drhigsby/letitslide/_QMK stuff/letitslide/readme.md

# Let It Slide!

Let It Slide!

Let It Slide! Is a 14u wide 40% keyboard featuring a potentiometer slider and full punctuation.   

* Keyboard Maintainer: [H. Bond](https://github.com/drhigsby)
* Hardware Supported: Let It Slide! (https://github.com/drhigsby/letitslide)
* Hardware Availability: Make your own

Make example for this keyboard (after setting up your build environment):

    make letitslide:default

See the [build environment setup](https://docs.qmk.fm/#/getting_started_build_tools) and the [make instructions](https://docs.qmk.fm/#/getting_started_make_guide) for more information. Brand new to QMK? Start with our [Complete Newbs Guide](https://docs.qmk.fm/#/newbs).
