drhigsby/letitslide/_Case/DXFs/letItSlide LAYER E x1.dxf

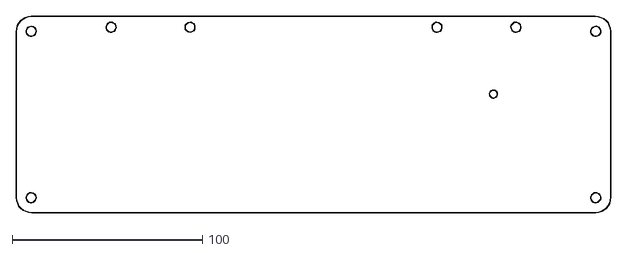
[picture p1: CAD file, 2022-01-31]
_Case/DXFs/letItSlide LAYER E x1.dxf
312.8 x 103.2
