drhigsby/letitslide/_Case/DXFs/letItSlide LAYER C1 x1.dxf

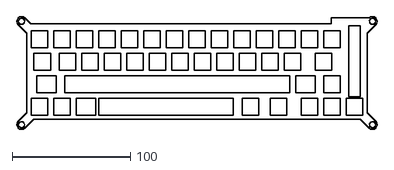
[picture p2: CAD file, 2022-01-31]
_Case/DXFs/letItSlide LAYER C1 x1.dxf
305.8 x 96.3
