drhigsby/letitslide/_Case/DXFs/letItSlide LAYER B x1.dxf

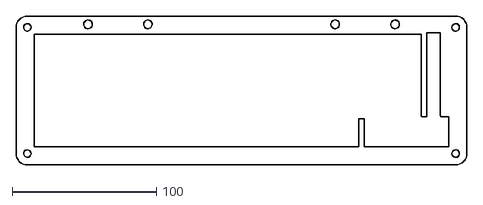
[picture p3: CAD file, 2022-01-31]
_Case/DXFs/letItSlide LAYER B x1.dxf
312.8 x 103.2
