drhigsby/letitslide/_Case/DXFs/letItSlide Foot A x2.dxf

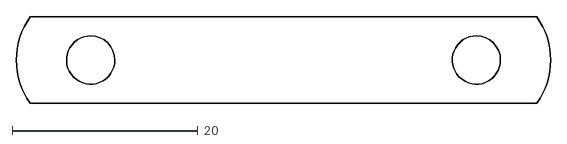
[picture p5: CAD file, 2022-01-31]
_Case/DXFs/letItSlide Foot A x2.dxf
57.5 x 9.29
