drhigsby/letitslide/_Case/DXFs/letItSlide LAYER A x1.dxf

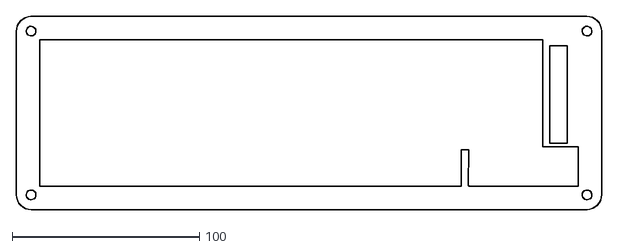
[picture p6: CAD file, 2022-01-31]
_Case/DXFs/letItSlide LAYER A x1.dxf
312.8 x 103.2
