drhigsby/letitslide/_Case/DXFs/letItSlide Foot B x4.dxf

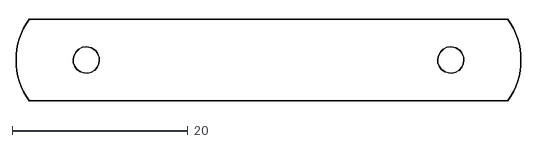
[picture p7: CAD file, 2022-01-31]
_Case/DXFs/letItSlide Foot B x4.dxf
57.5 x 9.29
