drhigsby/letitslide/_Case/DXFs/letItSlide LAYER D x3.dxf

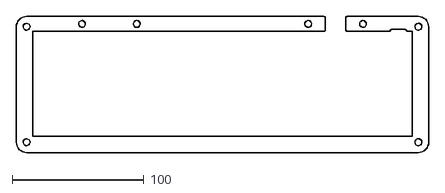
[picture p8: CAD file, 2022-01-31]
_Case/DXFs/letItSlide LAYER D x3.dxf
312.8 x 103.2
