drhigsby/letitslide/letItSlide.kicad_pcb

## KiCad design letItSlide.kicad_pcb (2022-04-28)

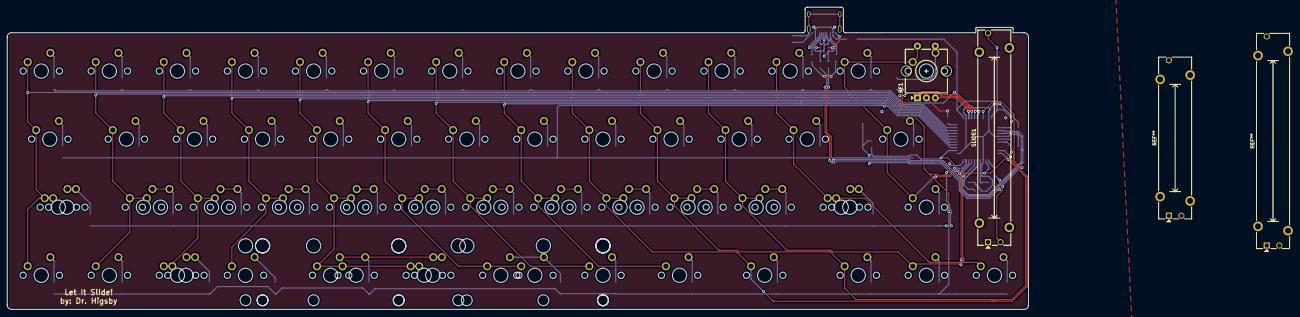
[picture p9: board letItSlide.kicad_pcb from above]

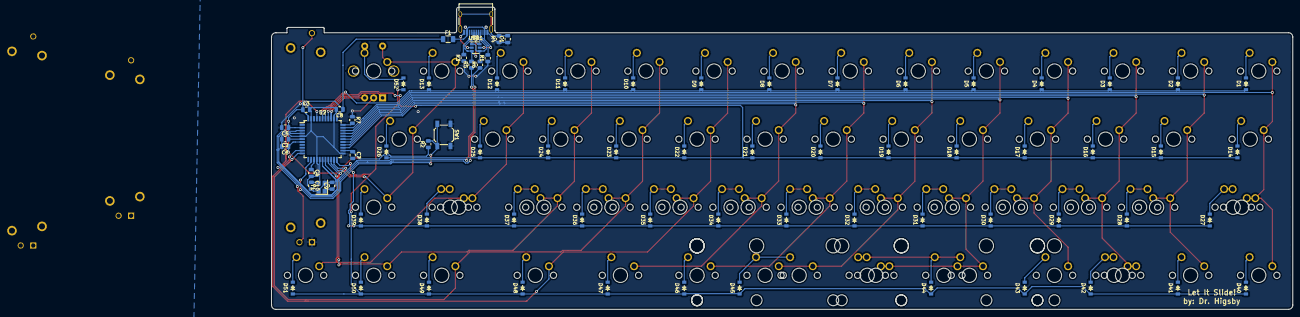
[picture p10: board letItSlide.kicad_pcb from below]

Board: 2 copper layers, 285.8 x 84.5 mm, 146 parts (75 on the bottom side), 87 nets.

Parts:
C1: 4.7n; C_0805_2012Metric
C2: 1uF; C_0805_2012Metric
C3, C4, C5, C6, C7: 0.1uF; C_0805_2012Metric
C8: 10uF; C_0805_2012Metric
C9, C10: 22; C_0805_2012Metric
D1, D2, D3, D4, D5, D6, D7, D8, D9, D10, D11, D12, D13, D14, D15, D16, D17, D18, D19, D20, D21, D22, D23, D24, D25, D26, D27, D28, D29, D30, D31, D32, D33, D34, D35, D36, D37, D38, D39, D40, D41, D42, D43, D44, D45, D46, D47, D48, D49, D50, D51, D52: D_Small; D_SOD-123
F1: 500 mA; Fuse_1206_3216Metric
MX1, MX2, MX3, MX4, MX5, MX6, MX7, MX8, MX9, MX10, MX11, MX12, MX13, MX15, MX16, MX17, MX18, MX19, MX20, MX21, MX22, MX23, MX24, MX25, MX28, MX28#2, MX29, MX29#2, MX30, MX30#2, MX31, MX31#2, MX32, MX32#2, MX33, MX33#2, MX34, MX34#2, MX35, MX35#2, MX36, MX36#2, MX37, MX37#2, MX39, MX40, MX41, MX42, MX43, MX46, MX49, MX50, MX51, MX52: MX-NoLED; MXOnly-1U-NoLED
MX14, MX38-1.25u1, MX42-1.25u1, MX47, MX48: MX-NoLED; MXOnly-1.25U-NoLED
MX26, MX27-1.75u1: MX-NoLED; MXOnly-1.75U-NoLED
MX27, MX38: MX-NoLED; MXOnly-1.5U-NoLED
MX44: MX-NoLED; MXOnly-2.25U-ReversedStabilizers-NoLED
MX44-3u1, MX45-3u1: MX-NoLED; MXOnly-3U-ReversedStabilizers-NoLED
MX44-6.25u1: MX-NoLED; MXOnly-6.25U-ReversedStabilizers-NoLED
MX44-6u1: MX-NoLED; MXOnly-6U-Centered-ReversedStabilizers-NoLED
MX45: MX-NoLED; MXOnly-2U-ReversedStabilizers-NoLED
R1, R3: 5.1k; R_0805_2012Metric
R2, R7: 10k; R_0805_2012Metric
R4: 1M; R_0805_2012Metric
R5, R6: 22; R_0805_2012Metric
RE1: Rotary_Encoder_Switch; RotaryEncoder_Alps_EC11E-Switch_Vertical_H20mm_CircularMoun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
SLIDE1: Conn_01x07_Male; Potentiometer_Bourns_PTA4543_Single_Slide
SW1: SW_Push; SW_SPST_SKQG_WithStem
U1: SRV05-4; SOT-23-6
U2: ATmega32U4-AU; TQFP-44_10x10mm_P0.8mm
USB1: USB_C_Receptacle_USB2.0; USB_C_Receptacle_HRO_TYPE-C-31-M-12
Y1: Crystal_GND24_Small; Crystal_SMD_3225-4Pin_3.2x2.5mm

Connections:
+5V: C3.1, C4.1, C5.1, C6.1, C7.1, C8.1, F1.1, R2.1, SLIDE1.3, U2.2, U2.7, U2.14, U2.24, U2.34, U2.44
ANAL_IN: SLIDE1.2, U2.41
D+: R5.2, U1.3, U1.6, USB1.A6, USB1.B6
D-: R6.2, U1.1, U1.4, USB1.A7, USB1.B7
Earth: C1.2, R4.2, USB1.S1
GND: C1.1, C2.2, C3.2, C4.2, C5.2, C6.2, C7.2, C8.2, C9.2, C10.2, R1.1, R3.1, R4.1, R7.1, RE1.C, SLIDE1.1, SW1.1, U1.2, U2.5, U2.15, U2.23, U2.35, U2.43, USB1.A1, USB1.A12, USB1.B1, USB1.B12, Y1.2, Y1.4
MG1: RE1.B, U2.36
MG2: RE1.A, U2.37
unnamed: C2.1, U2.6
unnamed: C9.1, U2.17, Y1.1
unnamed: C10.1, U2.16, Y1.3
unnamed: D1.2, MX1.2
unnamed: D2.2, MX2.2
unnamed: D3.2, MX3.2
unnamed: D4.2, MX4.2
unnamed: D5.2, MX5.2
unnamed: D6.2, MX6.2
unnamed: D7.2, MX7.2
unnamed: D8.2, MX8.2
unnamed: D9.2, MX9.2
unnamed: D10.2, MX10.2
unnamed: D11.2, MX11.2
unnamed: D12.2, MX12.2
unnamed: D13.2, MX13.2
unnamed: D14.2, MX14.2
unnamed: D15.2, MX15.2
unnamed: D16.2, MX16.2
unnamed: D17.2, MX17.2
unnamed: D18.2, MX18.2
unnamed: D19.2, MX19.2
unnamed: D20.2, MX20.2
unnamed: D21.2, MX21.2
unnamed: D22.2, MX22.2
unnamed: D23.2, MX23.2
unnamed: D24.2, MX24.2
unnamed: D25.2, MX25.2
unnamed: D26.2, MX26.2
unnamed: D27.2, MX27.2, MX27-1.75u1.2
unnamed: D28.2, MX28.2, MX28#2.2
unnamed: D29.2, MX29.2, MX29#2.2
unnamed: D30.2, MX30.2, MX30#2.2
unnamed: D31.2, MX31.2, MX31#2.2
unnamed: D32.2, MX32.2, MX32#2.2
unnamed: D33.2, MX33.2, MX33#2.2
unnamed: D34.2, MX34.2, MX34#2.2
unnamed: D35.2, MX35.2, MX35#2.2
unnamed: D36.2, MX36.2, MX36#2.2
unnamed: D37.2, MX37.2, MX37#2.2
unnamed: D38.2, MX38.2, MX38-1.25u1.2
unnamed: D39.2, MX39.2
unnamed: D40.2, MX40.2
unnamed: D41.2, MX41.2
unnamed: D42.2, MX42.2, MX42-1.25u1.2
unnamed: D43.2, MX43.2
unnamed: D44.2, MX44.2, MX44-3u1.2, MX44-6.25u1.2, MX44-6u1.2
unnamed: D45.2, MX45.2, MX45-3u1.2
unnamed: D46.2, MX46.2
unnamed: D47.2, MX47.2
unnamed: D48.2, MX48.2
unnamed: D49.2, MX49.2
unnamed: D50.2, MX50.2
unnamed: D51.2, MX51.2
unnamed: D52.2, MX52.2, RE1.S1
unnamed: R1.2, USB1.A5
unnamed: R2.2, SW1.2, U2.13
unnamed: R3.2, USB1.B5
unnamed: R5.1, U2.4
unnamed: R6.1, U2.3
unnamed: R7.2, U2.33
VCC: F1.2, U1.5, USB1.A4, USB1.A9, USB1.B4, USB1.B9
c1: MX1.1, MX14.1, MX27.1, MX27-1.75u1.1, MX40.1, U2.32
c2: MX2.1, MX15.1, MX28.1, MX28#2.1, MX41.1, U2.31
c3: MX3.1, MX16.1, MX29.1, MX29#2.1, MX42.1, MX42-1.25u1.1, U2.30
c4: MX4.1, MX17.1, MX30.1, MX30#2.1, MX43.1, U2.29
c5: MX5.1, MX18.1, MX31.1, MX31#2.1, MX44.1, MX44-3u1.1, MX44-6.25u1.1, MX44-6u1.1, U2.28
c6: MX6.1, MX19.1, MX32.1, MX32#2.1, MX45.1, MX45-3u1.1, U2.27
c7: MX7.1, MX20.1, MX33.1, MX33#2.1, MX46.1, U2.26
c8: MX8.1, MX21.1, MX34.1, MX34#2.1, MX47.1, U2.25
c9: MX9.1, MX22.1, MX35.1, MX35#2.1, MX48.1, U2.10
c10: MX10.1, MX23.1, MX36.1, MX36#2.1, MX49.1, U2.11
c11: MX11.1, MX24.1, MX37.1, MX37#2.1, MX50.1, U2.19
c12: MX12.1, MX25.1, MX38.1, MX38-1.25u1.1, MX51.1, U2.18
c13: MX13.1, MX26.1, MX39.1, MX52.1, RE1.S2, U2.20
r1: D1.1, D2.1, D3.1, D4.1, D5.1, D6.1, D7.1, D8.1, D9.1, D10.1, D11.1, D12.1, D13.1, U2.39
r2: D14.1, D15.1, D16.1, D17.1, D18.1, D19.1, D20.1, D21.1, D22.1, D23.1, D24.1, D25.1, D26.1, U2.38
r3: D27.1, D28.1, D29.1, D30.1, D31.1, D32.1, D33.1, D34.1, D35.1, D36.1, D37.1, D38.1, D39.1, U2.22
r4: D40.1, D41.1, D42.1, D43.1, D44.1, D45.1, D46.1, D47.1, D48.1, D49.1, D50.1, D51.1, D52.1, U2.21
