drhigsby/letitslide/_QMK stuff/letitslide/config.h

/* Copyright 2021 drhigsby
 *
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
 * You should have received a copy of the GNU General Public License
 * along with this program.  If not, see <http://www.gnu.org/licenses/>.
 */
#pragma once

#include "config_common.h"

/* USB Device descriptor parameter */
#define MANUFACTURER DrHigsby
#define PRODUCT Let It Slide!
#define VENDOR_ID 0x0007
#define PRODUCT_ID 0x0001
#define DEVICE_VER 0x0005

/* key matrix size */
#define MATRIX_ROWS 4
#define MATRIX_COLS 13

/*
 * Keyboard Matrix Assignments
 *
 * Change this to how you wired your keyboard
 * COLS: AVR pins used for columns, left to right
 * ROWS: AVR pins used for rows, top to bottom
 * DIODE_DIRECTION: COL2ROW = COL = Anode (+), ROW = Cathode (-, marked on diode)
 *                  ROW2COL = ROW = Anode (+), COL = Cathode (-, marked on diode)
 *
 */

/* key matrix pins */
#define MATRIX_ROW_PINS { F4, F5, D5, D3 }
#define MATRIX_COL_PINS { C7, C6, B6, B5, B4, D7, D6, D4, B2, B3, D1, D0, D2 }
#define UNUSED_PINS

/*slider pin */
#define POT_PIN F0

/* COL2ROW or ROW2COL */
#define DIODE_DIRECTION COL2ROW

/* Debounce reduces chatter (unintended double-presses) - set 0 if debouncing is not needed */
#define DEBOUNCE 5

/* Mechanical locking support. Use KC_LCAP, KC_LNUM or KC_LSCR instead in keymap */
#define LOCKING_SUPPORT_ENABLE
/* Locking resynchronize hack */
#define LOCKING_RESYNC_ENABLE

/* Define encoder pads */
#define ENCODERS_PAD_A { F7 }
#define ENCODERS_PAD_B { F6 }
